MohamedNabil70/water-pump-control/Damasy router LAN settings.png

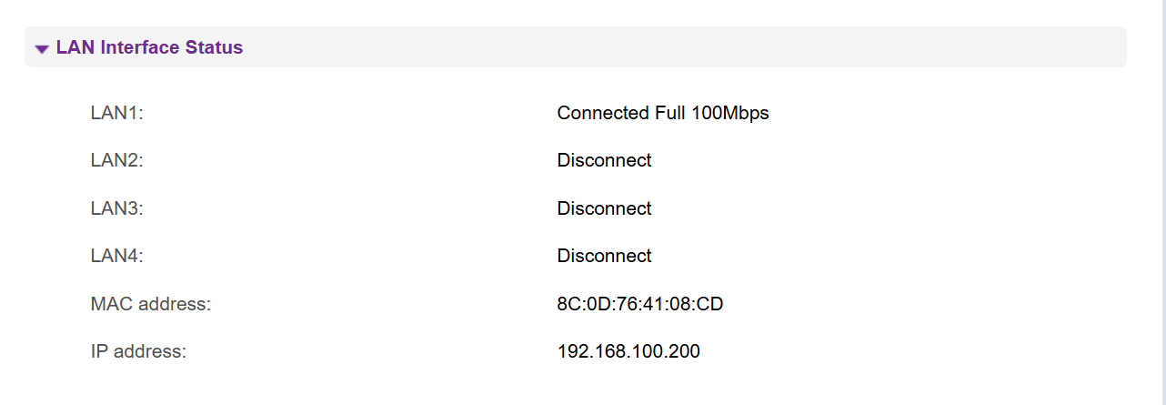
Damasy router LAN settings.png
