MohamedNabil70/water-pump-control/(commit log)

2026-09-10 Initial commit: ESP32 water pump remote control
2026-09-25 Move feedback to GPIO 13, reserve GPIO 33 for fan output
2026-11-01 Move survey credentials to secrets.h; link PumpLink; fix stale README status
